hermanjaime/nilm-tinyml-esp32/docs/fig01_accuracy_per_class.png

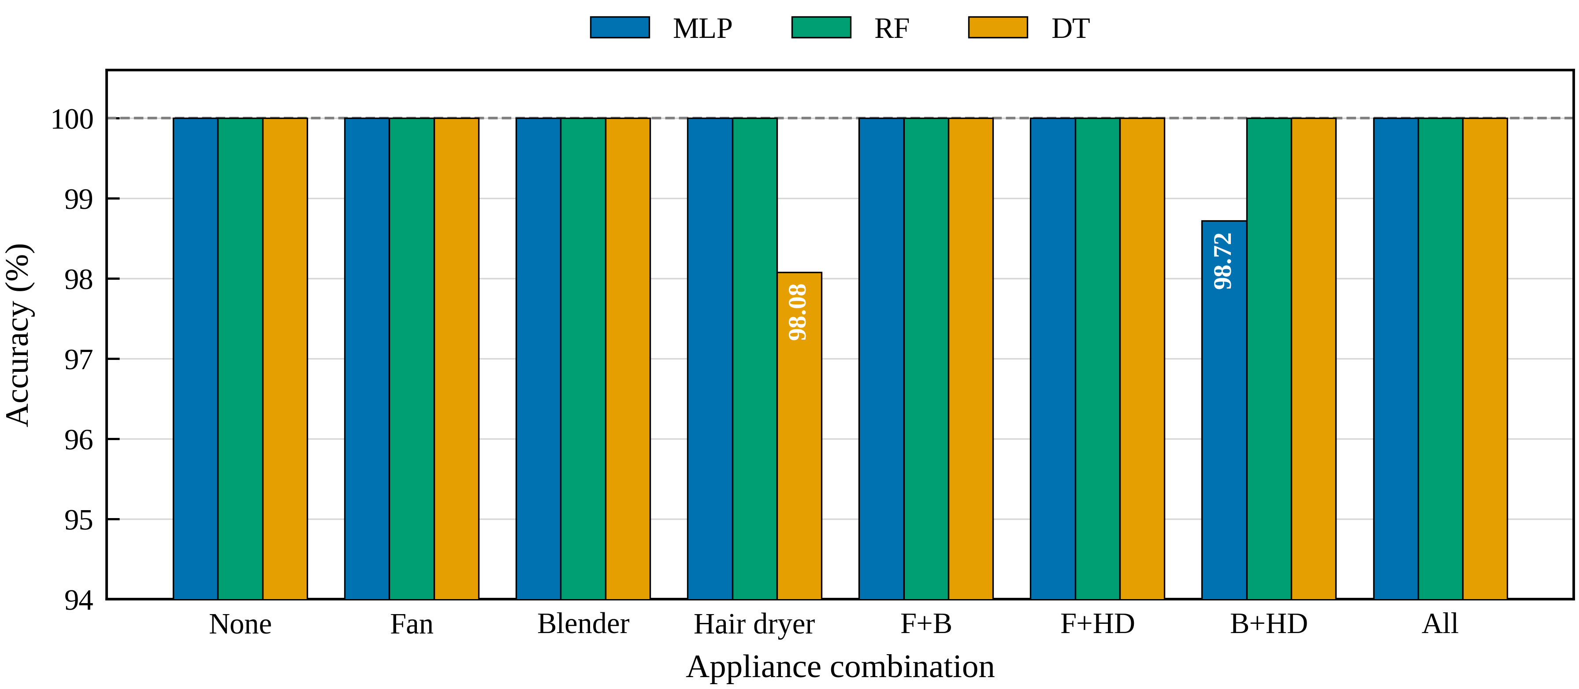
docs/fig01_accuracy_per_class.png
