hermanjaime/nilm-tinyml-esp32/docs/fig02_individual_loads.png

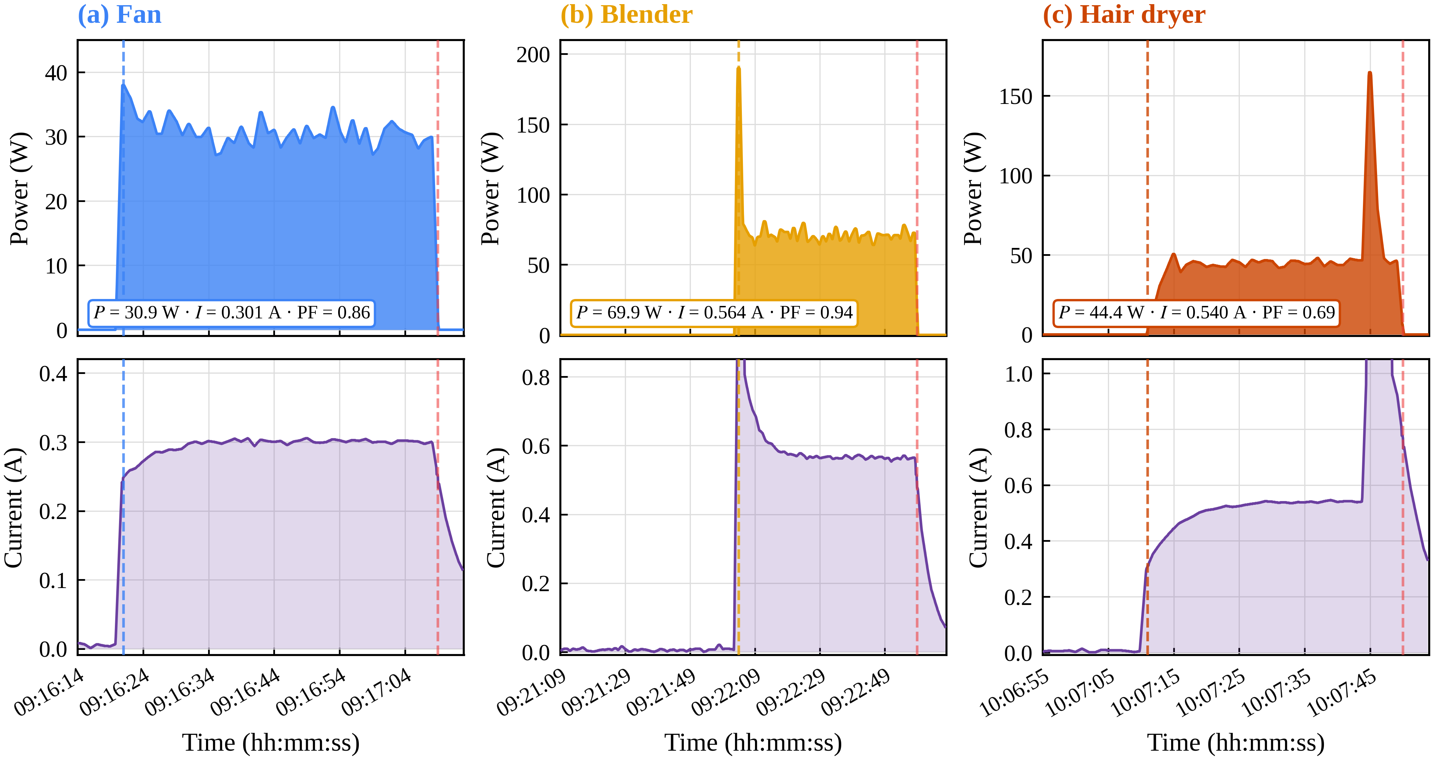
docs/fig02_individual_loads.png
