hermanjaime/nilm-tinyml-esp32/docs/fig03_confusion_matrices.png

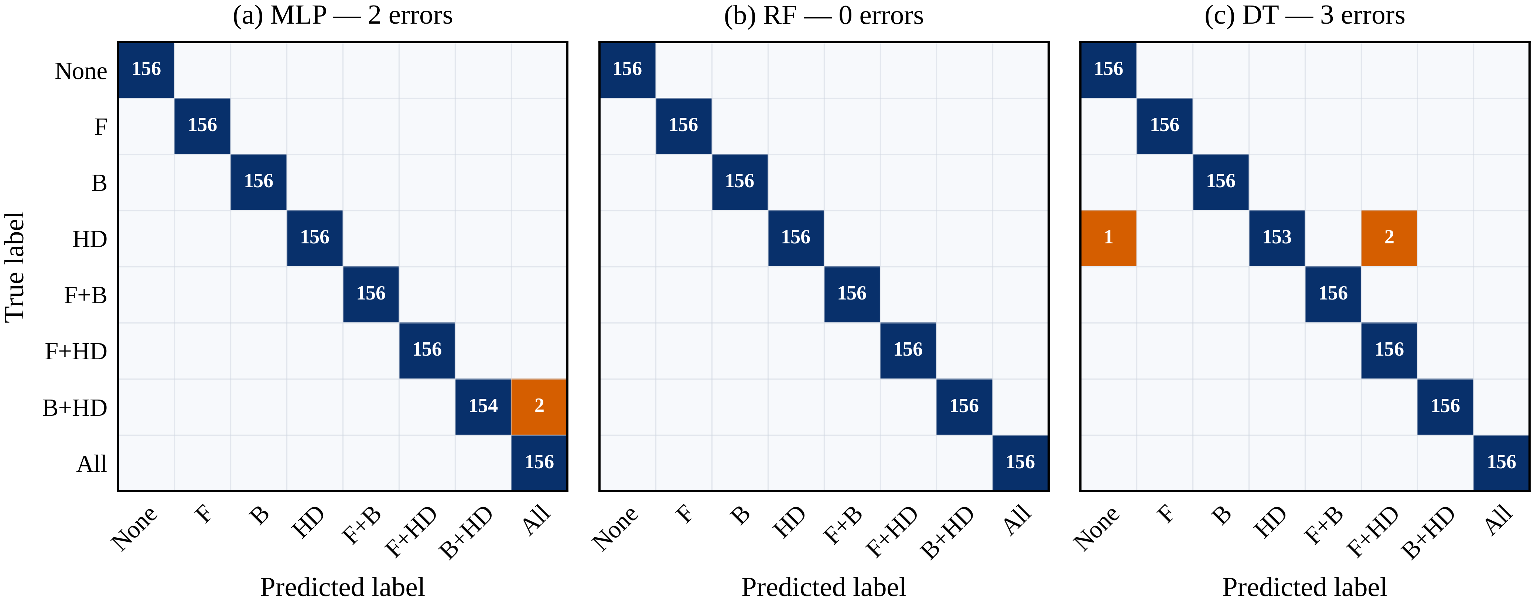
docs/fig03_confusion_matrices.png
