hermanjaime/nilm-tinyml-esp32/docs/fig04_feature_importance.png

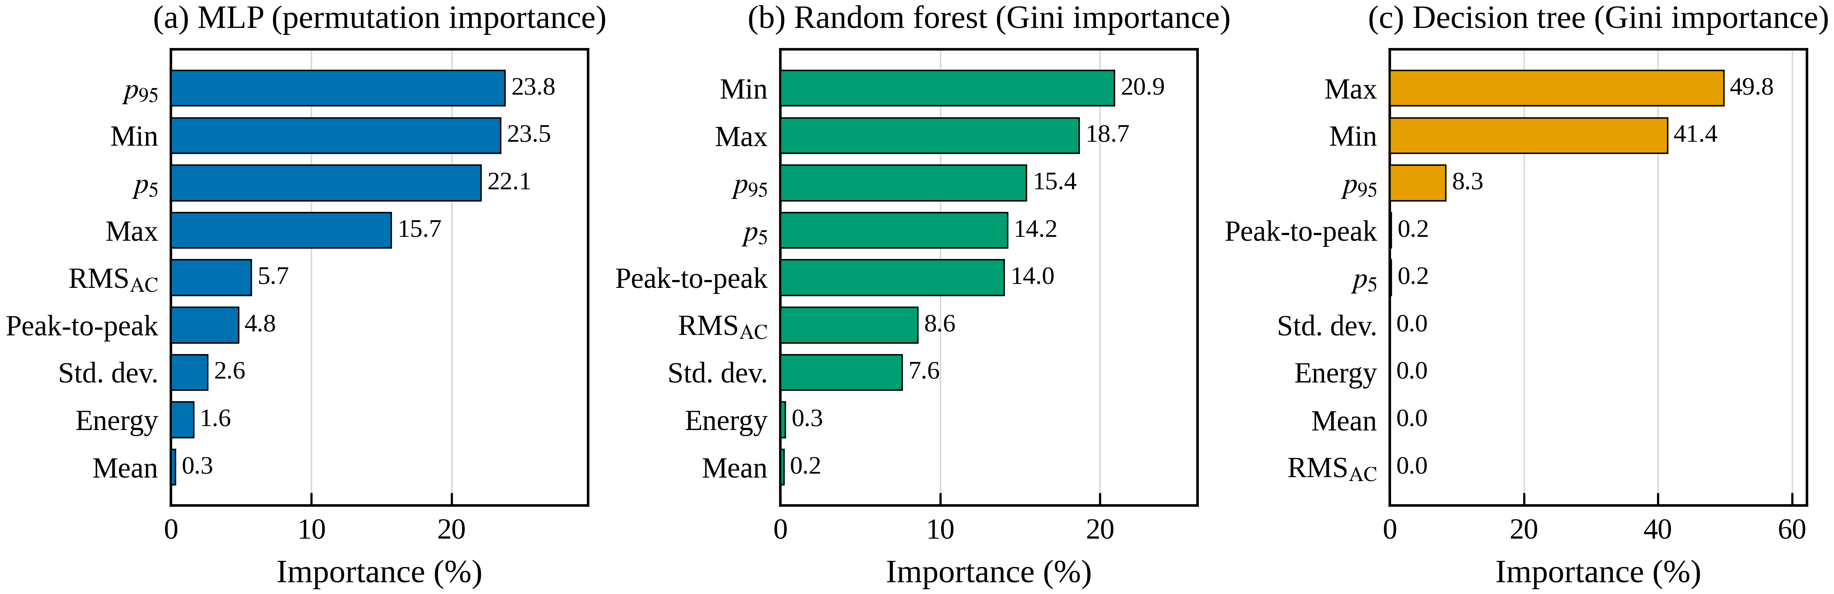
docs/fig04_feature_importance.png
