hermanjaime/nilm-tinyml-esp32/docs/fig05_mlp_learning_curve.png

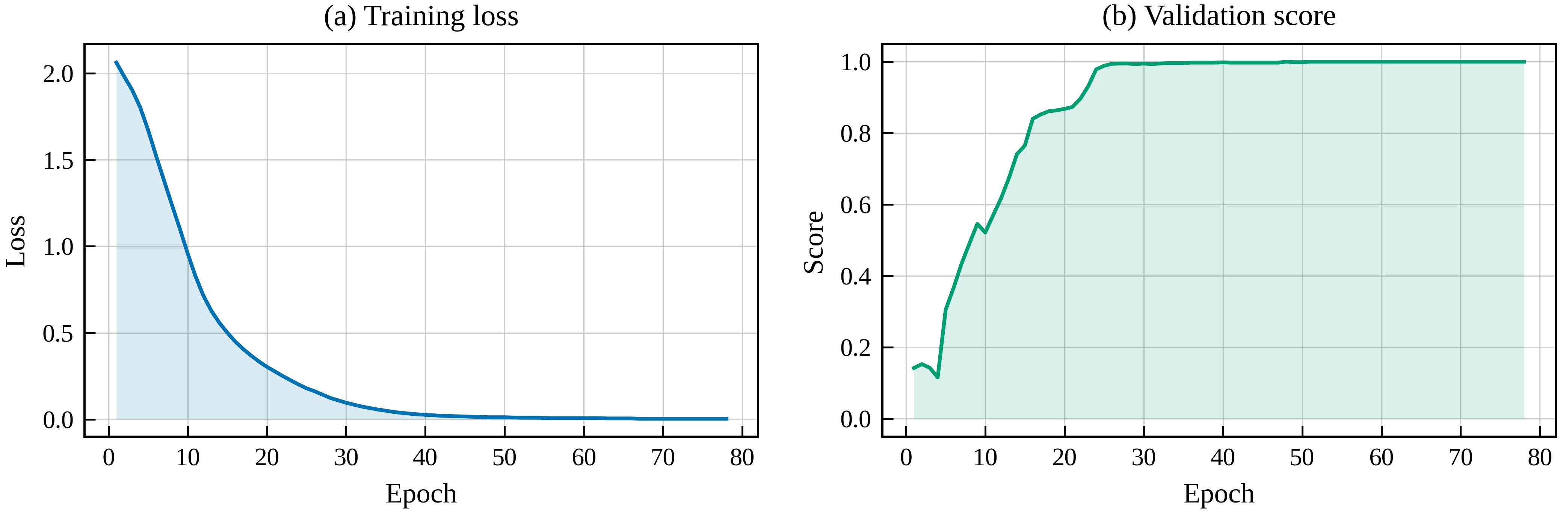
docs/fig05_mlp_learning_curve.png
