hermanjaime/nilm-tinyml-esp32/docs/fig06_learning_curves.png

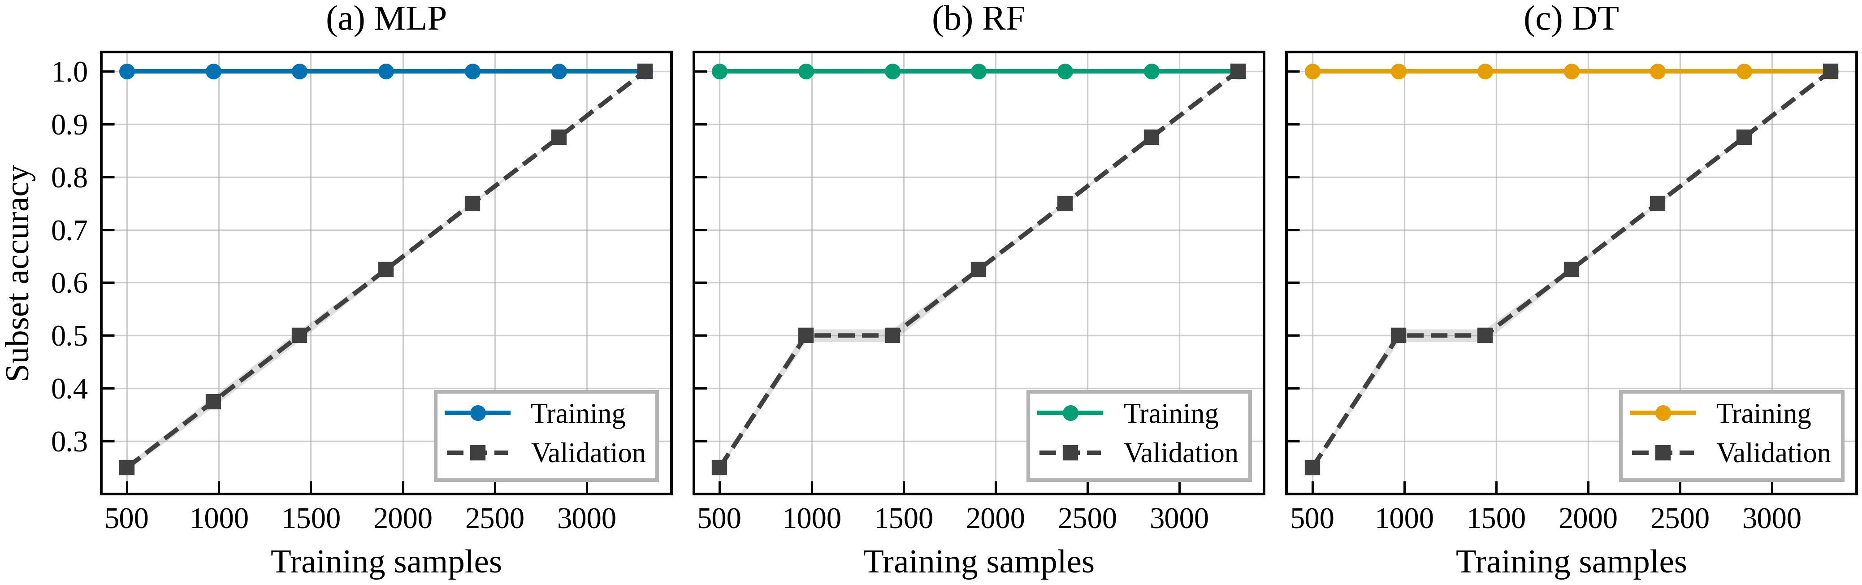
docs/fig06_learning_curves.png
