hermanjaime/nilm-tinyml-esp32/docs/fig_current_events.png

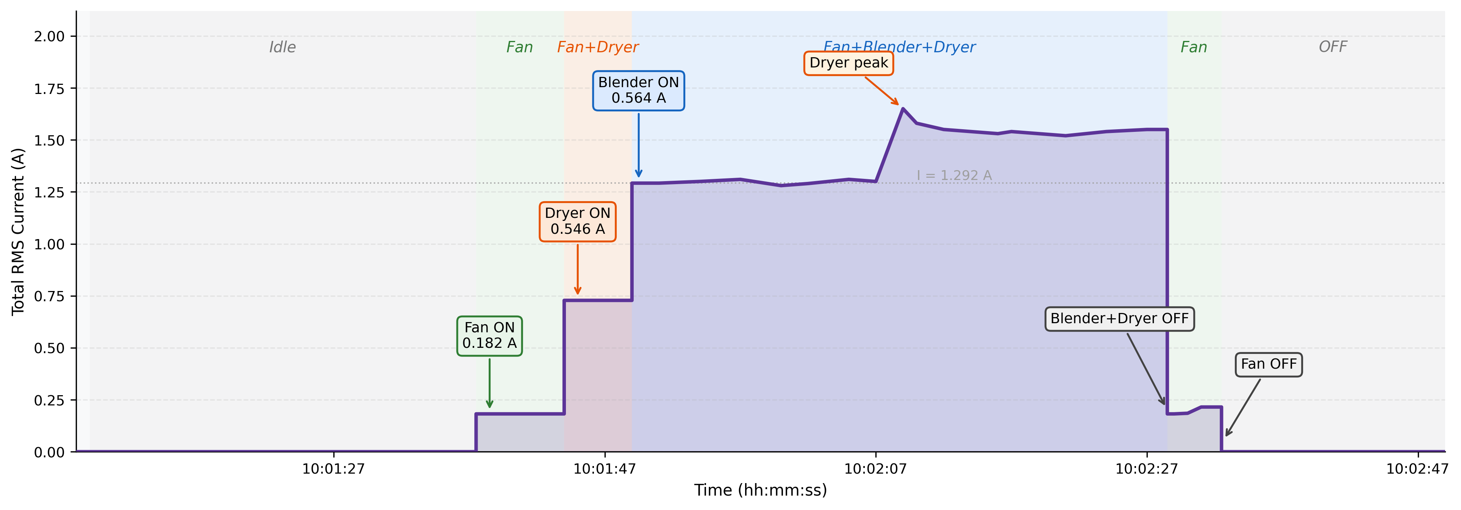
docs/fig_current_events.png
