hermanjaime/nilm-tinyml-esp32/docs/fig_openset.png

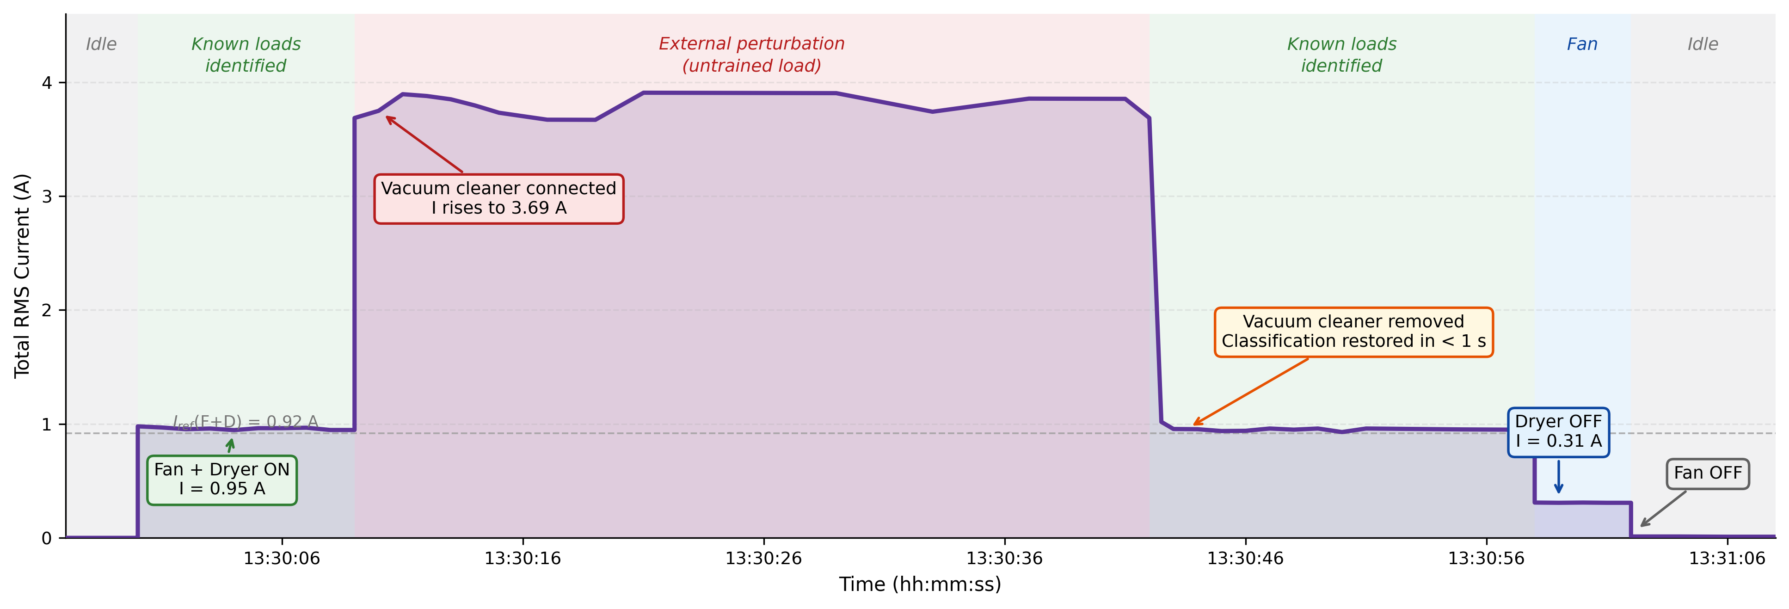
docs/fig_openset.png
