hermanjaime/nilm-tinyml-esp32/docs/fig_separability.png

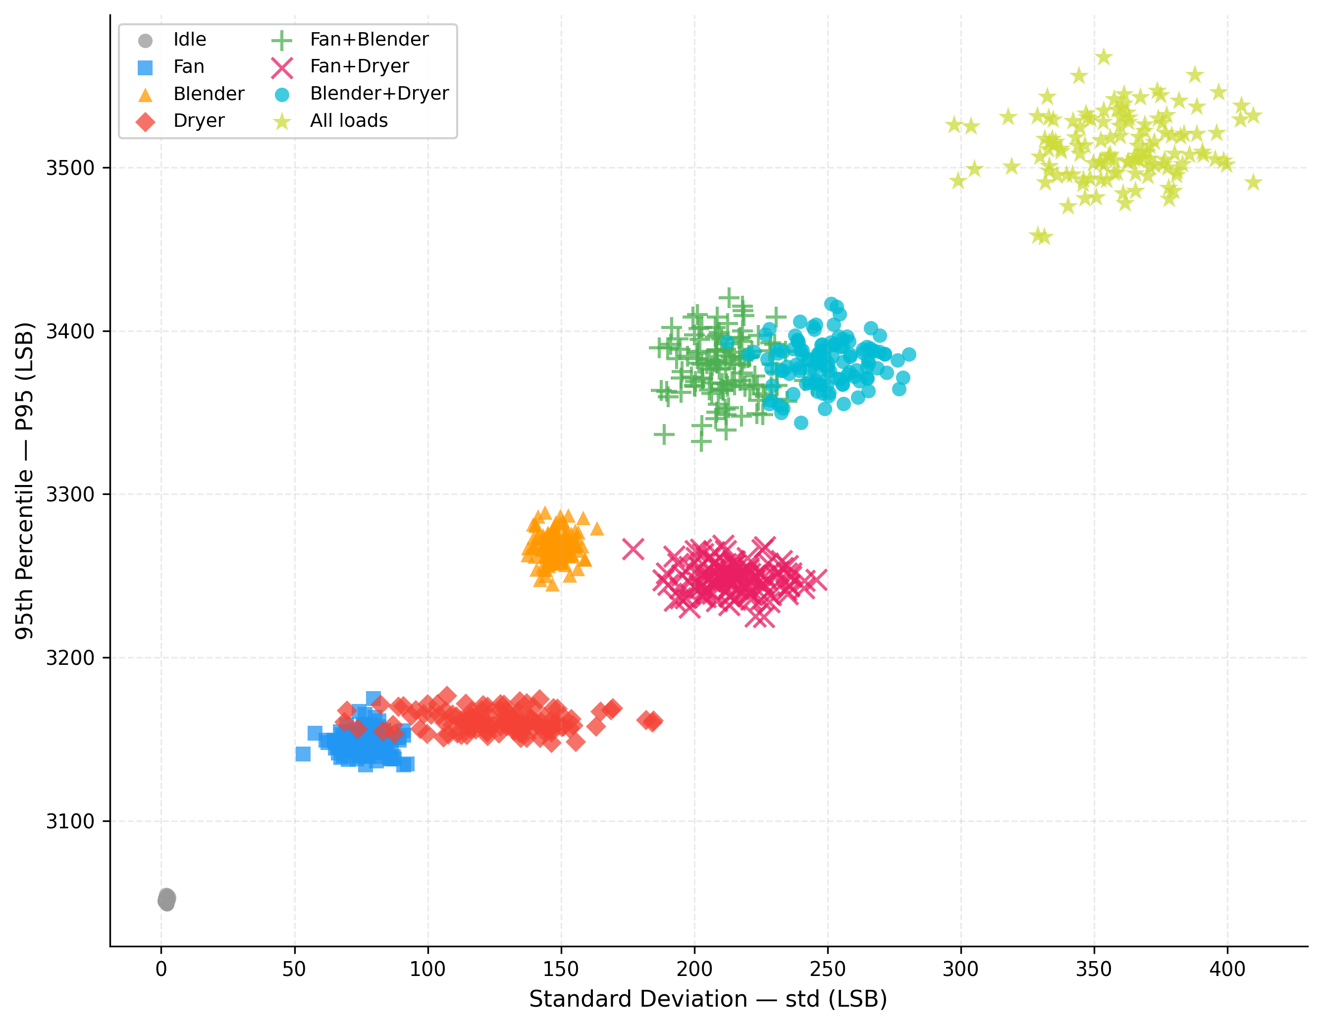
docs/fig_separability.png
