hermanjaime/nilm-tinyml-esp32/docs/fig_waveforms.png

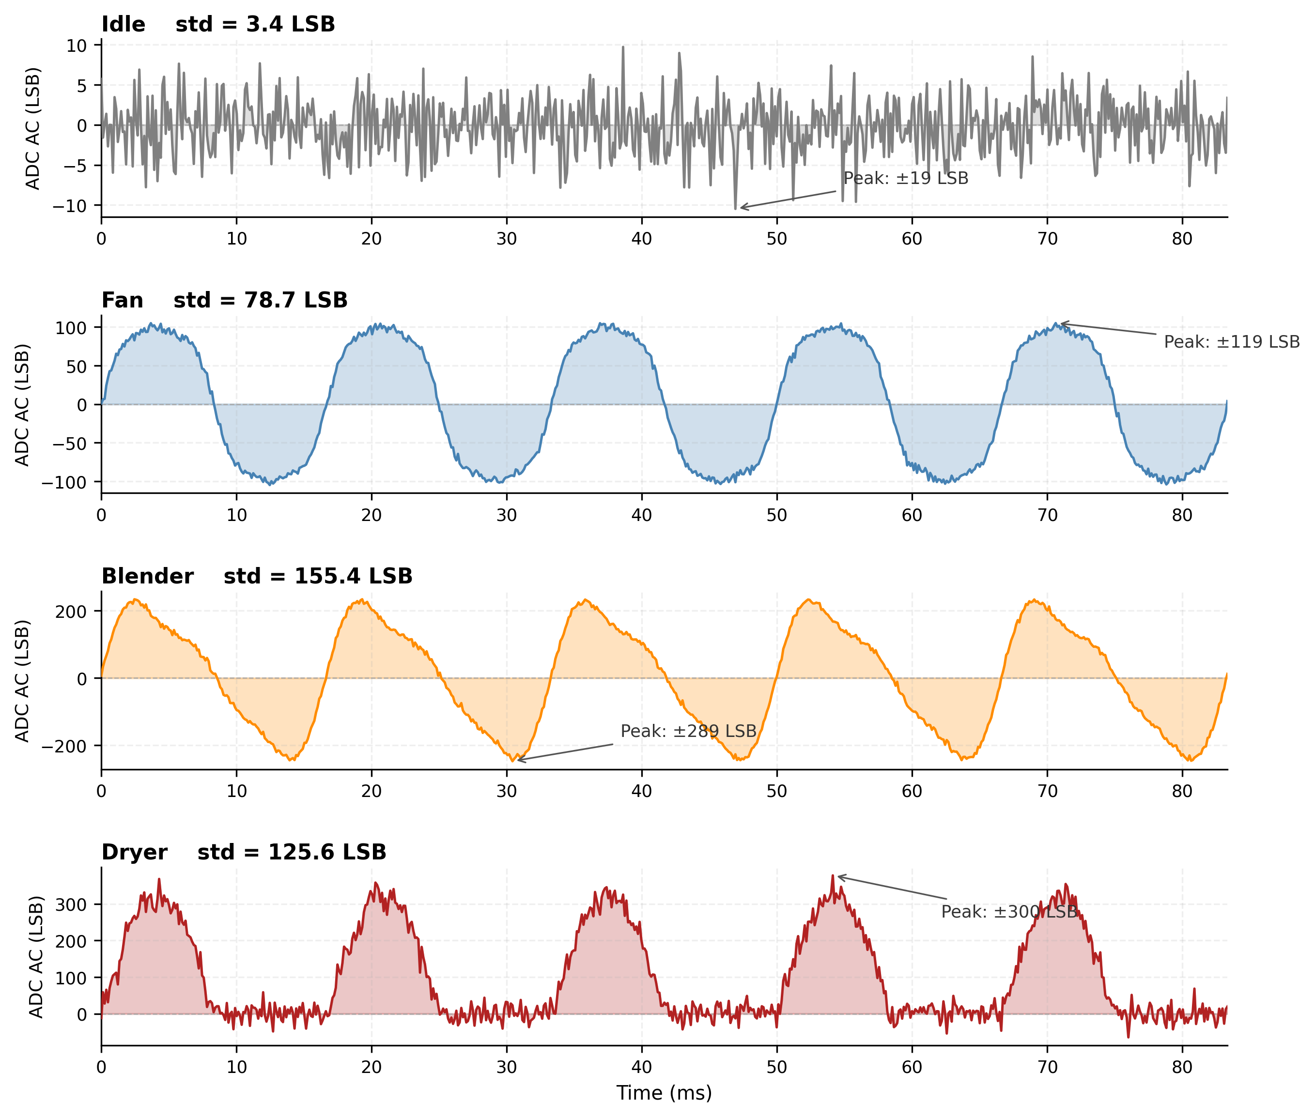
docs/fig_waveforms.png
