hermanjaime/nilm-tinyml-esp32/docs/figA_power_comparison_3loads.png

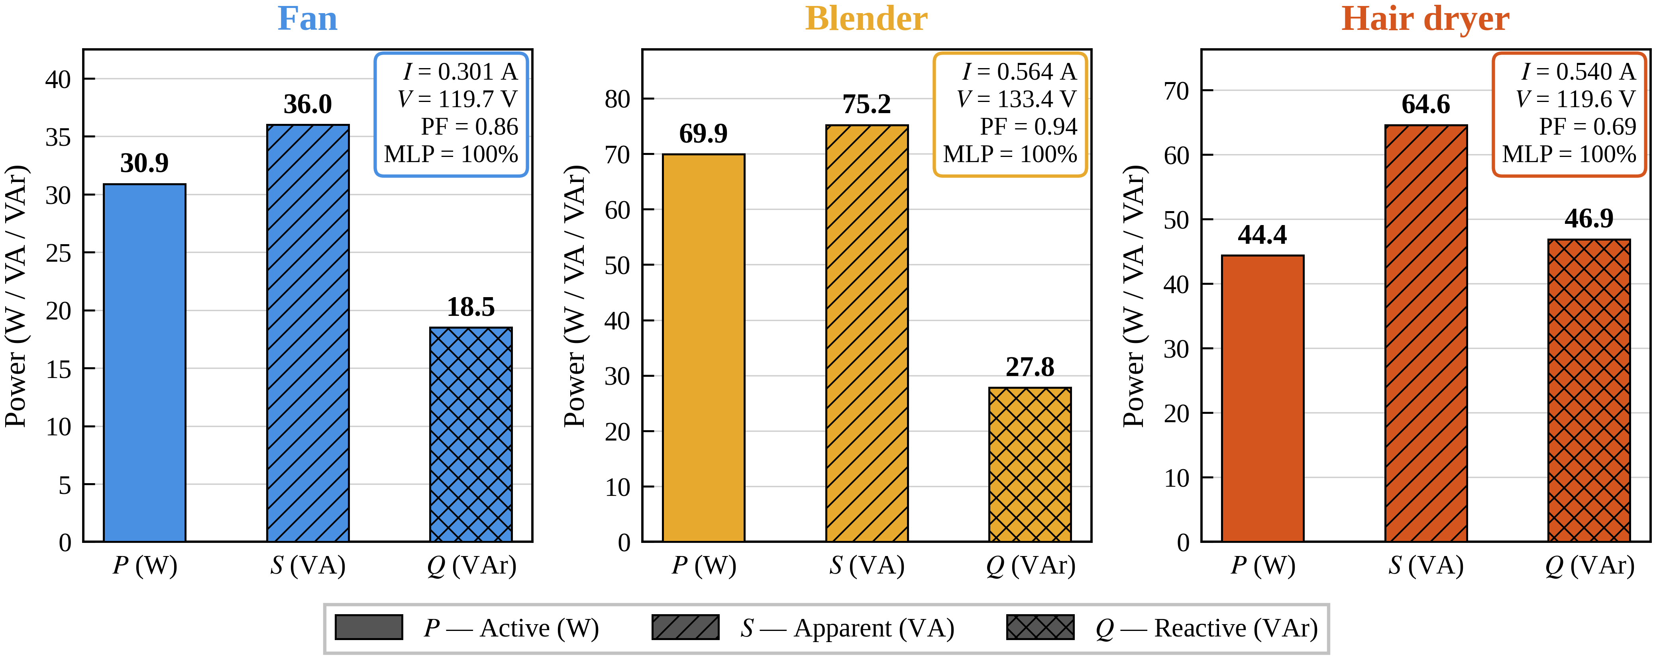
docs/figA_power_comparison_3loads.png
