hermanjaime/nilm-tinyml-esp32/docs/fluxograma_1.png

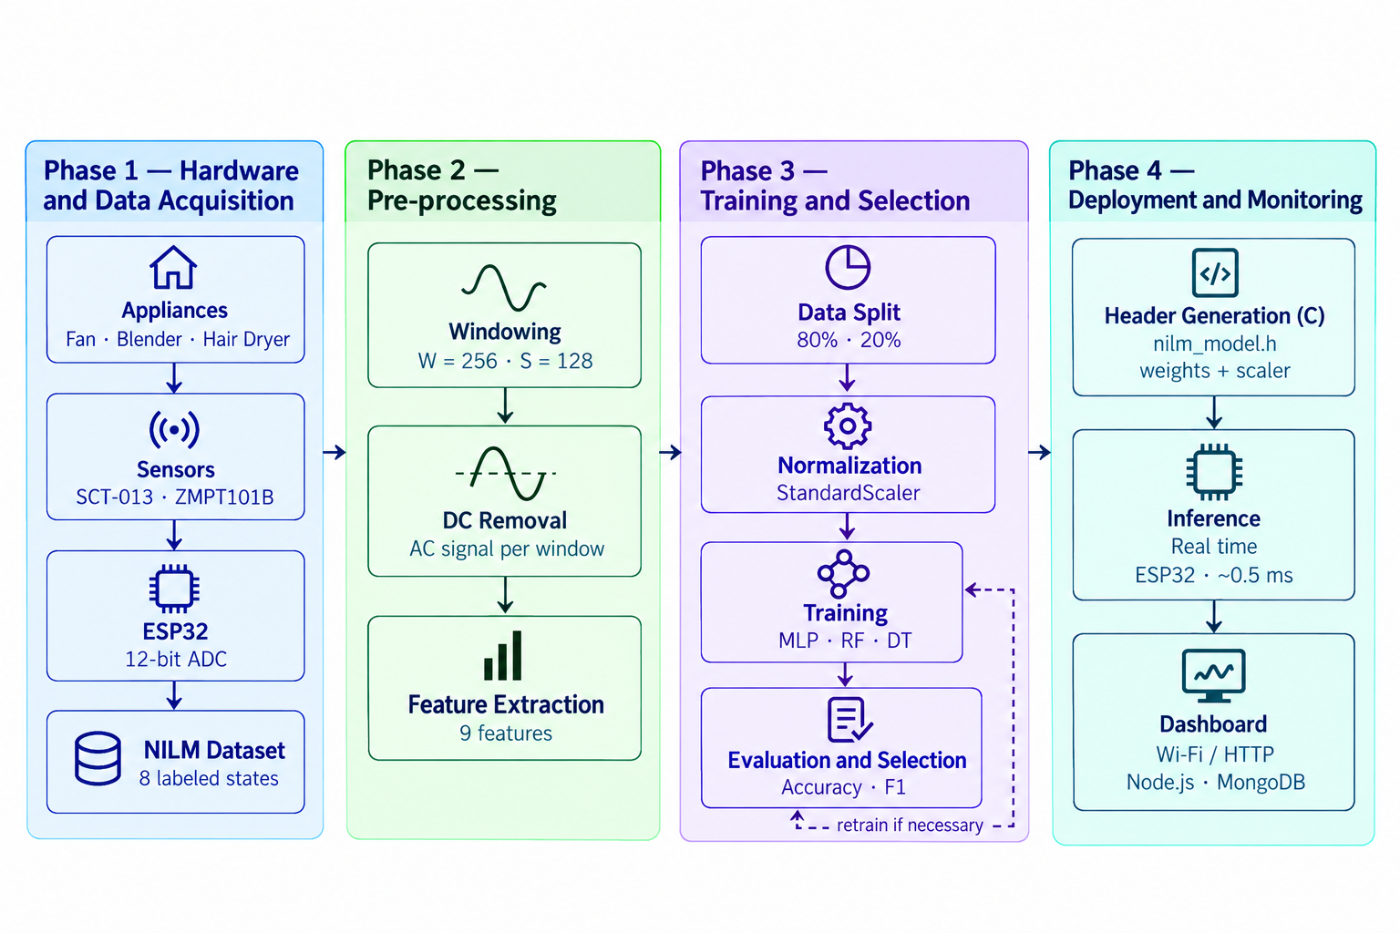
docs/fluxograma_1.png
