hermanjaime/nilm-tinyml-esp32/docs/fluxograma_2.png

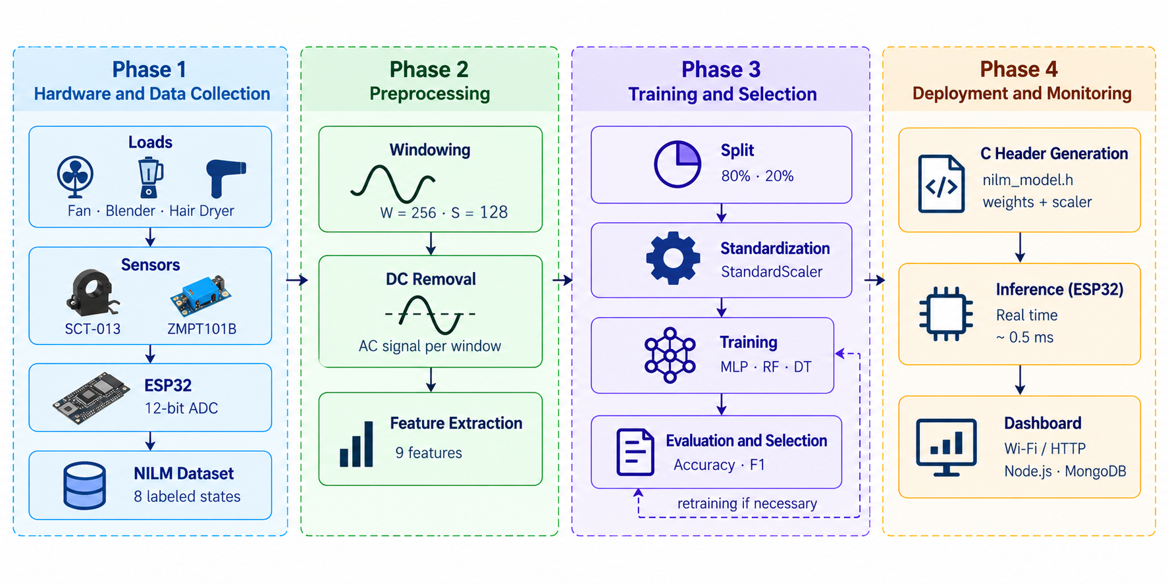
docs/fluxograma_2.png
