hermanjaime/nilm-tinyml-esp32/docs/mlp_architecture.png

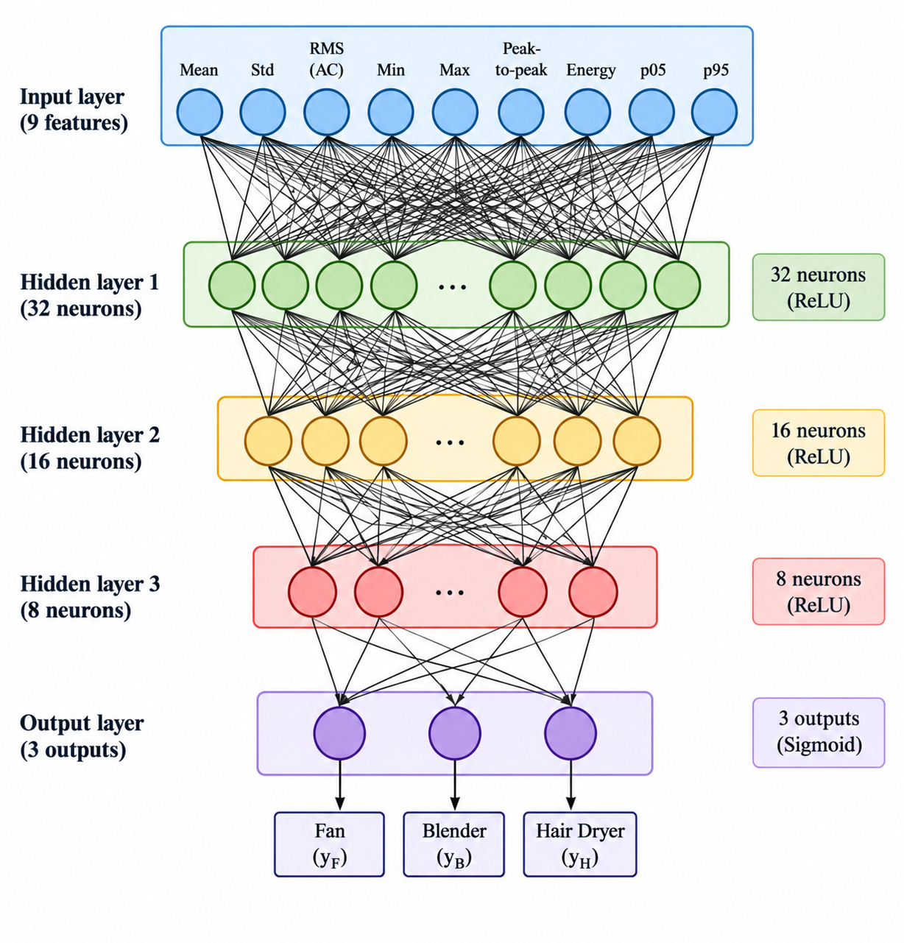
docs/mlp_architecture.png
