hermanjaime/nilm-tinyml-esp32/firmware/nilm_model.h

/**
 * nilm_model.h
 * NILM Dataset · fan / blender / hair dryer
 * WITHOUT median filter · WITHOUT amp_60Hz · 9 statistical features
 *
 * ESP32 pipeline:
 *   1. Accumulate 256 raw ADC samples (GPIO 36)
 *   2. Extract 9 features    (nilm_extract_s3)
 *   3. Normalize             (nilm_normalize_s3)
 *   4. MLP forward pass      (nilm_predict_s3)
 *   5. Classify              (nilm_classify_s3)
 *
 * Metrics (hold-out, 1248 windows):
 *   Accuracy : 99.84%   Macro F1 : 0.9995
 *   Errors   : 2             Hamming  : 0.0005
 *
 * Labels: [0]=fan  [1]=blender  [2]=hair dryer
 */

#ifndef NILM_MODEL_S3_H
#define NILM_MODEL_S3_H

#include <stdint.h>
#include <math.h>
#include <string.h>
#include <stdlib.h>

#define NILM_N_FEATURES   9
#define NILM_N_OUTPUTS    3
#define NILM_WINDOW_SIZE  256
#define NILM_STEP_SIZE    128
#define NILM_THRESHOLD    0.5f

static const char* NILM_FEATURE_NAMES[] = {
    "mean","std","rms_ac","min","max","peak_to_peak","energy","p05","p95"
};
static const char* NILM_LABEL_NAMES[] = {
    "fan","blender","hair dryer"
};

/* ── StandardScaler ─────────────────────────────────────────── */
static const float NILM_SCALER_MEAN[NILM_N_FEATURES] = {
    3043.33369697f, 181.61458568f, 181.61458568f,
    2733.75521251f, 3290.76383320f, 557.00862069f,
    2382903563.06635904f, 2752.00330794f, 3273.71486568f
};
static const float NILM_SCALER_STD[NILM_N_FEATURES] = {
    40.93185362f, 108.06376712f, 108.06376712f,
    177.48003158f, 160.09143701f, 327.44782962f,
    65443231.76595496f, 171.14582505f, 149.10075651f
};

/* ── MLP weights 9→32→16→8→3 ───────────────────────────────── */
static const float NILM_W0[9][32] = {
    {0.05949553f, 0.30157392f, 0.19759909f, 0.04487221f, -0.34623974f, -0.35025976f, -0.36491951f, 0.13860685f, 0.00093128f, 0.20372825f, -0.63825910f, 0.28420544f, 0.05086932f, 0.03018476f, -0.00069986f, -0.27680295f, 0.10003610f, 0.16770105f, -0.02709954f, -0.20223715f, 0.15665864f, -0.31277288f, -0.17939012f, -0.34442127f, 0.05965384f, -0.03393083f, -0.13356440f, 0.03486818f, -0.12303703f, -0.26992558f, -0.13127425f, -0.13924942f},
    {-0.33331253f, 0.72919631f, 0.44524165f, 0.16580563f, -0.48255263f, -0.29967323f, 0.20963314f, -0.49707557f, -0.02561150f, 0.28162143f, -0.20351109f, 0.49259353f, 0.04010143f, 0.34756969f, -0.13948526f, -0.21093095f, 0.06629320f, 0.08523105f, 0.47345067f, 0.05132133f, 0.37331193f, 0.21982637f, 0.26237236f, 0.23449493f, -0.70601332f, -0.64390555f, -0.10444800f, -0.10116025f, 0.25214897f, -0.53162586f, 0.15894539f, -0.09617093f},
    {-0.16815596f, 0.41844957f, -0.18491048f, 0.16106227f, -0.65855867f, 0.38061585f, 0.27696517f, -0.68177662f, -0.11475089f, 0.52664661f, 0.31090520f, 0.35465170f, 0.43215399f, -0.10264860f, -0.10371787f, -0.52016102f, 0.30834593f, 0.42066134f, -0.01515057f, -0.49301846f, -0.10749953f, -0.21592750f, 0.36313109f, 0.01698283f, -0.09497396f, -0.43258097f, -0.04755523f, 0.19561827f, 0.53682325f, -0.30982305f, 0.11475140f, 0.00866757f},
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
    {1.25444434f, -0.50350225f, 0.93865624f},
    {-0.04234385f, -0.42725400f, 0.02374886f},
    {0.04130866f, 0.00267470f, 0.01570034f},
    {0.00008832f, 0.00057774f, 0.03053142f},
};
static const float NILM_B3[3] = {
    -0.65325440f, 0.31756303f, -0.29201532f
};

/* ── Comparator for qsort (percentiles) ────────────────────── */
static int nilm_cmpf(const void *a, const void *b) {
    float fa=*(const float*)a, fb=*(const float*)b;
    return (fa>fb)-(fa<fb);
}

/* ── Extraction of the 9 features ──────────────────────────── */
static inline void nilm_extract_s3(const float w[NILM_WINDOW_SIZE],
                                    float out[NILM_N_FEATURES]) {
    int i;
    float sum=0.0f, ssq=0.0f, mn=w[0], mx=w[0];
    for(i=0;i<NILM_WINDOW_SIZE;i++) {
        sum+=w[i]; ssq+=w[i]*w[i];
        if(w[i]<mn) mn=w[i];
        if(w[i]>mx) mx=w[i];
    }
    float mean=sum/(float)NILM_WINDOW_SIZE, var=0.0f;
    for(i=0;i<NILM_WINDOW_SIZE;i++) { float d=w[i]-mean; var+=d*d; }
    float std_v=sqrtf(var/(float)NILM_WINDOW_SIZE);

    float sorted[NILM_WINDOW_SIZE];
    memcpy(sorted, w, sizeof(float)*NILM_WINDOW_SIZE);
    qsort(sorted, NILM_WINDOW_SIZE, sizeof(float), nilm_cmpf);

    out[0]=mean;           /* mean         */
    out[1]=std_v;          /* std          */
    out[2]=std_v;          /* rms_ac == std (mean already removed) */
    out[3]=mn;             /* min          */
    out[4]=mx;             /* max          */
    out[5]=mx-mn;          /* peak_to_peak */
    out[6]=ssq;            /* energy       */
    out[7]=sorted[(int)(0.05f*(NILM_WINDOW_SIZE-1))];  /* p05 */
    out[8]=sorted[(int)(0.95f*(NILM_WINDOW_SIZE-1))];  /* p95 */
}

/* ── Normalization (StandardScaler) ────────────────────────── */
static inline void nilm_normalize_s3(const float raw[NILM_N_FEATURES],
                                      float out[NILM_N_FEATURES]) {
    for(int i=0;i<NILM_N_FEATURES;i++)
        out[i]=(raw[i]-NILM_SCALER_MEAN[i])/NILM_SCALER_STD[i];
}

/* ── Forward Pass MLP ──────────────────────────────────────── */
static inline void nilm_predict_s3(const float sc[NILM_N_FEATURES],
                                    float out[NILM_N_OUTPUTS]) {
    float a0[32], a1[16], a2[8]; int i,j;
    for(j=0;j<32;j++) { float z=NILM_B0[j];
        for(i=0;i<9; i++) z+=sc[i]*NILM_W0[i][j]; a0[j]=z>0?z:0; }
    for(j=0;j<16;j++) { float z=NILM_B1[j];
        for(i=0;i<32;i++) z+=a0[i]*NILM_W1[i][j]; a1[j]=z>0?z:0; }
    for(j=0;j<8; j++) { float z=NILM_B2[j];
        for(i=0;i<16;i++) z+=a1[i]*NILM_W2[i][j]; a2[j]=z>0?z:0; }
    for(j=0;j<3; j++) { float z=NILM_B3[j];
        for(i=0;i<8; i++) z+=a2[i]*NILM_W3[i][j];
        out[j]=1.0f/(1.0f+expf(-z)); }
}

/* ── Classification ────────────────────────────────────────── */
static inline void nilm_classify_s3(const float out[NILM_N_OUTPUTS],
                                     uint8_t lbl[NILM_N_OUTPUTS],
                                     float threshold) {
    for(int j=0;j<NILM_N_OUTPUTS;j++)
        lbl[j]=(out[j]>=threshold)?1:0;
}

/* ── Complete pipeline (main entry function) ───────────────── */
static inline void nilm_run_s3(const float window[NILM_WINDOW_SIZE],
                                 float probs[NILM_N_OUTPUTS],
                                 uint8_t labels[NILM_N_OUTPUTS]) {
    float raw[NILM_N_FEATURES], sc[NILM_N_FEATURES];
    nilm_extract_s3(window, raw);
    nilm_normalize_s3(raw, sc);
    nilm_predict_s3(sc, probs);
    nilm_classify_s3(probs, labels, NILM_THRESHOLD);
}

#endif /* NILM_MODEL_S3_H */
