hermanjaime/nilm-tinyml-esp32/(commit log)

2026-09-21 Add NILM system source code and dataset
    Add ESP32 firmware, embedded MLP model, NILM dataset, data collection tool, training script, and web dashboard.
    [Dataset_NILM.csv]
2026-09-21 Update README with hardware and dashboard images
    Add the NILM prototype hardware setup, SCT-013 conditioning circuit, and web dashboard images to the project documentation.
